ZioGuido/Crumar_D9U/README.md

# GMLAB_D9U
This is the Arduino project for GMLAB D9U, an open source DIY drawbar controller.
Please refer to the included PDF for details about the project, the code and the electronics.
