ZioGuido/Crumar_D9U/Eagle/Crumar_D9U_Main.brd

## EAGLE design Eagle/Crumar_D9U_Main.brd (2019-01-29)

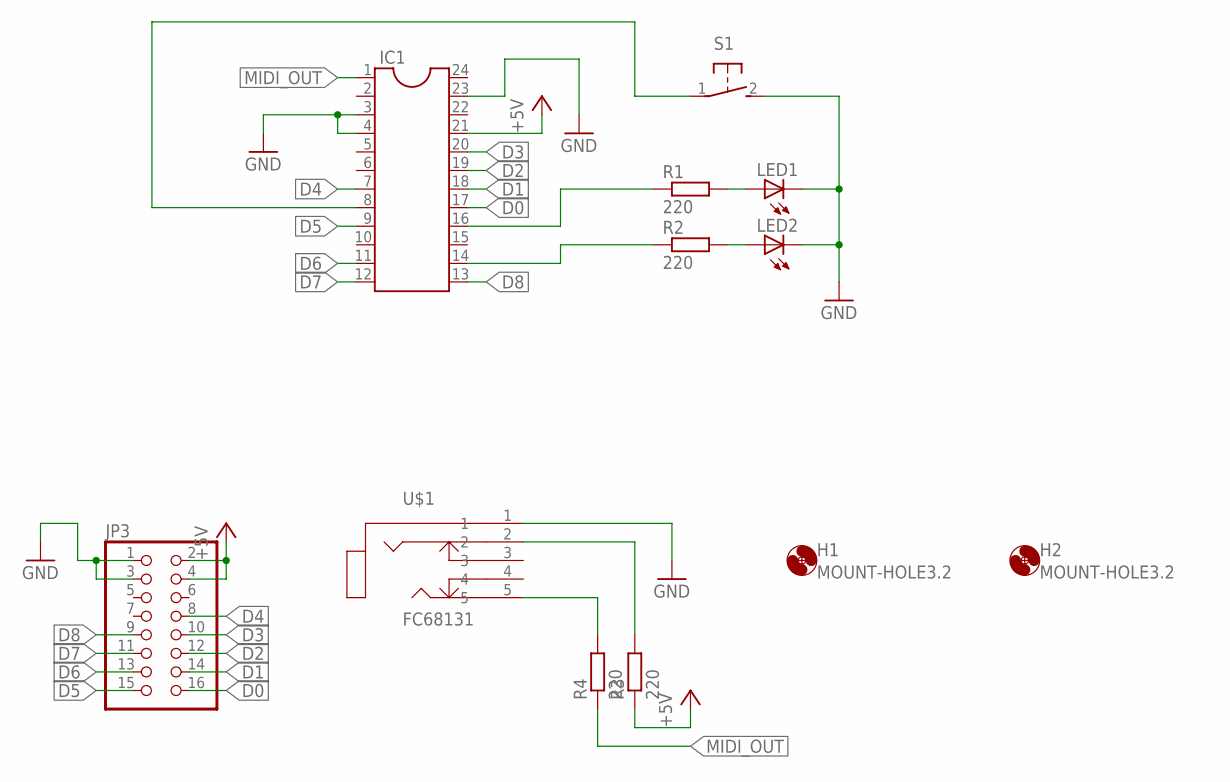
[picture p1: schematic Crumar_D9U_Main.sch]

Parts:
H1, H2: MOUNT-HOLE3.2; 3,2
IC1: DIL24-6
JP3: PINHD-2X8; 2X08
LED1, LED2: LED3MM
R1, R2, R3, R4: 220; 0207/7
S1: 31-XX; B3F-31XX
U$1: FC68131; FC68131-5P

Connections:
+5V: IC1.21, JP3.2, JP3.4, R3.1
D0: IC1.17, JP3.16
D1: IC1.18, JP3.14
D2: IC1.19, JP3.12
D3: IC1.20, JP3.10
D4: IC1.7, JP3.8
D5: IC1.9, JP3.15
D6: IC1.11, JP3.13
D7: IC1.12, JP3.11
D8: IC1.13, JP3.9
GND: IC1.3, IC1.4, IC1.23, JP3.1, JP3.3, LED1.K (C), LED2.K (C), S1.2 (S), U$1.1
LED1: IC1.16, R1.1
LED2: IC1.14, R2.1
MIDI_OUT: IC1.1, R4.1
unnamed: LED2.A, R2.2
unnamed: LED1.A, R1.2
unnamed: R3.2, U$1.2
unnamed: R4.2, U$1.5
SW: IC1.8, S1.1

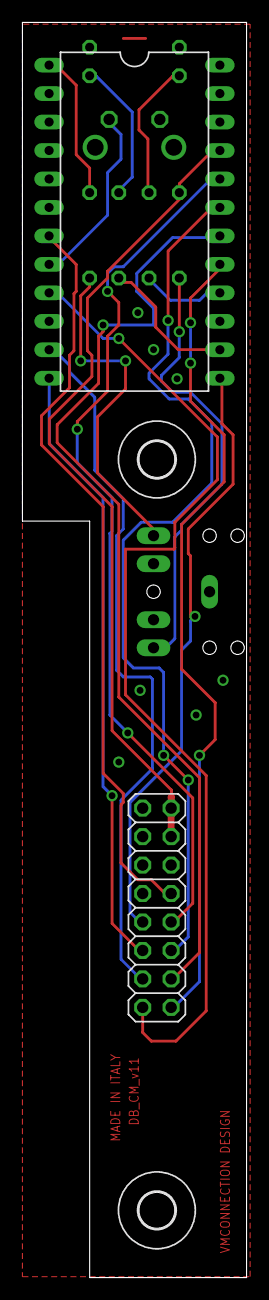
[picture p2: board Crumar_D9U_Main.brd from above]

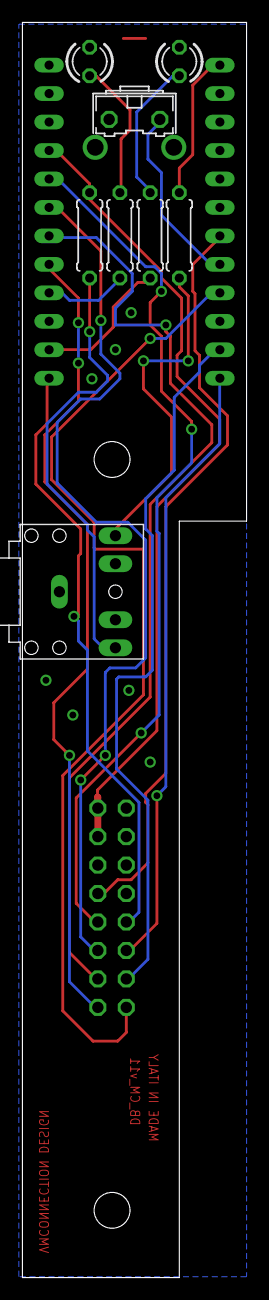
[picture p3: board Crumar_D9U_Main.brd from below]

Board: 2 copper layers, 20.0 x 112.0 mm, 12 parts (8 on the bottom side), 19 nets.
