ZioGuido/Crumar_D9U/(threads)

Thread 1 (2020-02-18):

Unnecessarily write to EEPROM

corvusnix, 2020-02-18:
Each time the device is started, the same value that has just been read is unneecessarily written into the EEPROM. The EEPROM memory has a specified lifetime of 100,000 write/erase cycles, so any unnecessary write command should be avoided. To fix this, `EEPROM.write(0x01, mode);` should be replaced by `EEPROM.update(0x01, mode);` in the function `set_mode()`.
Check out [Arduino Reference - EEPROMUpdate](https://www.arduino.cc/en/Reference/EEPROMUpdate) for details.

jlearman, 2022-10-31:
Good point, though I doubt I'd turn mine on more than 10,000 times. ;-)

ZioGuido, 2022-11-01:
If you turn it on once a day, every day, for 100K cycles it's 273 odd years.
I promise I will replace your $10 Arduino when it stops writing to EEPROM in 2295.

corvusnix, 2022-11-01:
I'm sorry to review your code and talk about the bad programming practices
I encountered. It won't happen again, I promise.

Mark Miles ***@***.***> schrieb am Di., 1. Nov. 2022, 19:13:

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

ZioGuido, 2022-11-01:
Ehm... That was just a joke...

Il Mar 1 Nov 2022, 20:36 corvusnix ***@***.***> ha scritto:

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

corvusnix, 2022-11-04:
Sorry, I didn't mean to be rude.
A weak power supply, for example, can trigger many resets in a short time.
This will wear out the EEPROM much faster than this optimistic calculation
assumes. There is no reason to let something like this break the device,
especially if it can be avoided. If there's one thing I've learned from
working with microcontrollers, it's that there are more pitfalls than a
developer can imagine.

Have a nice day

jlearman, 2022-11-11:
Sorry also, I didn't mean to be rude either.  The issue is valid, IMHO.

Closed 2022-11-01.
